Destination-SPACE/Weather-FeatherWing/README.md

# Weather FeatherWing
KiCad files for the Weather FeatherWing v1.4

## KiCanvas
View schematic and PCB files with [KiCanvas](https://kicanvas.org/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)

## Directory
### [🧾 Bill of Materials](manufacturing/assembly/weather-featherwing_bom.csv)
### [📐 Gerbers](manufacturing/fabrication/gerbers)
### [📰 Schematics](manufacturing/assembly)

Licensed under [CERN-OHL-P](LICENSE)
