Destination-SPACE/Weather-FeatherWing/manufacturing/assembly/weather-featherwing.pdf

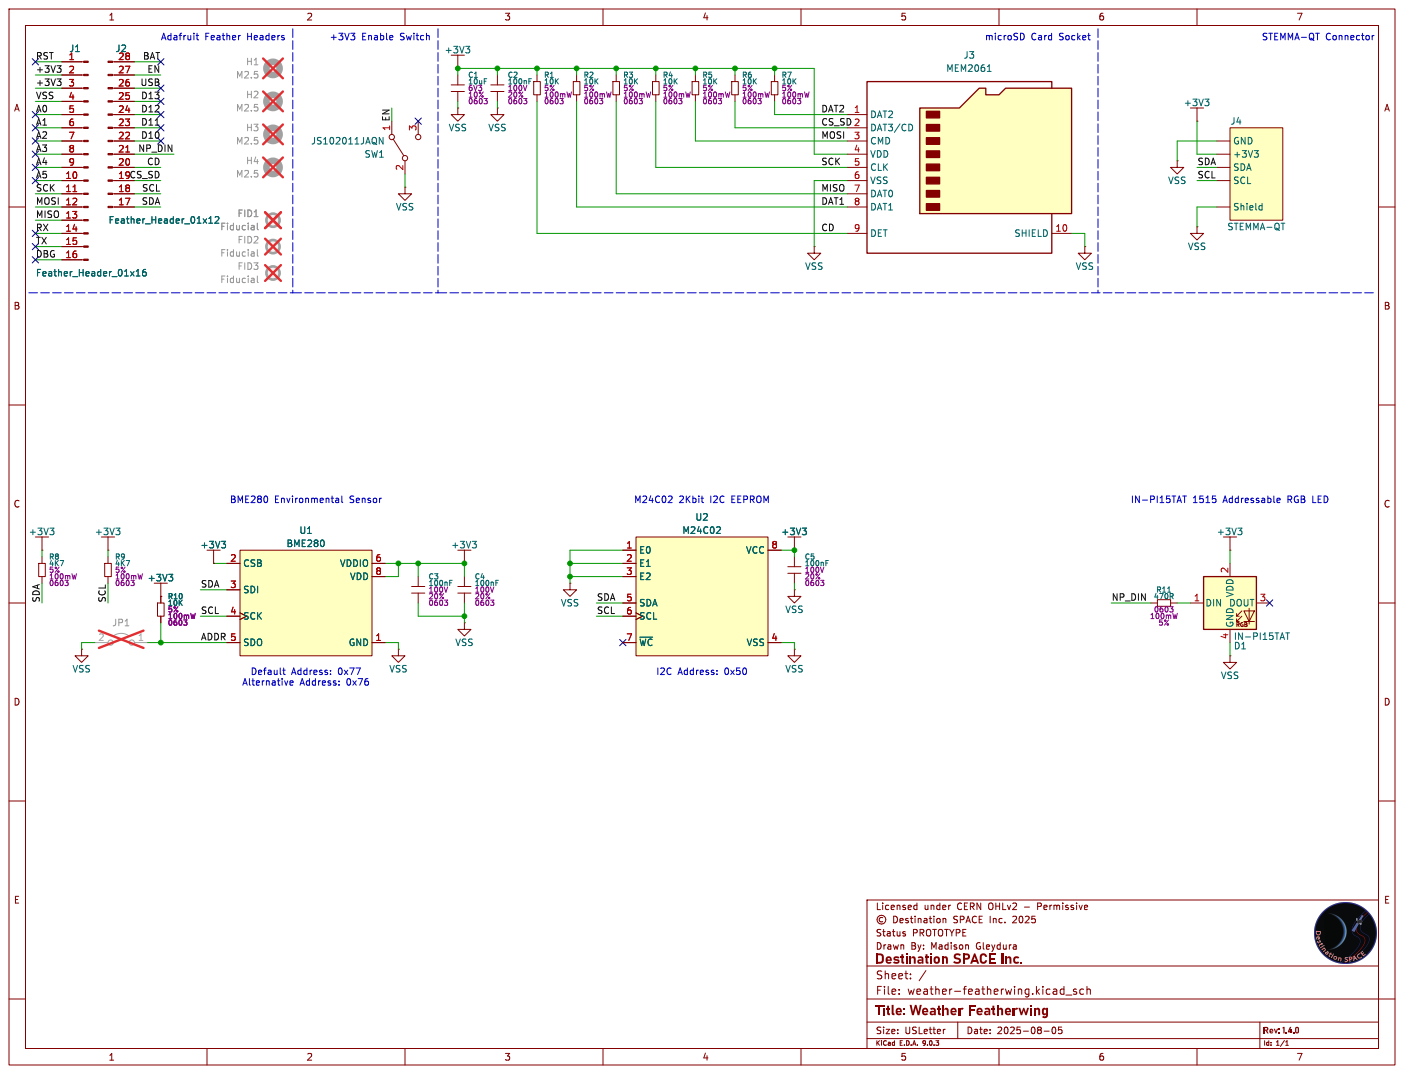
[picture p1: page 1]

Licensed under CERN OHLv2 - Permissive
DestinationSPACEInc. Drawn By: Madison Gleydura Status PROTOTYPE
