Destination-SPACE/Weather-FeatherWing/manufacturing/assembly/sch-v1_4_0.pdf

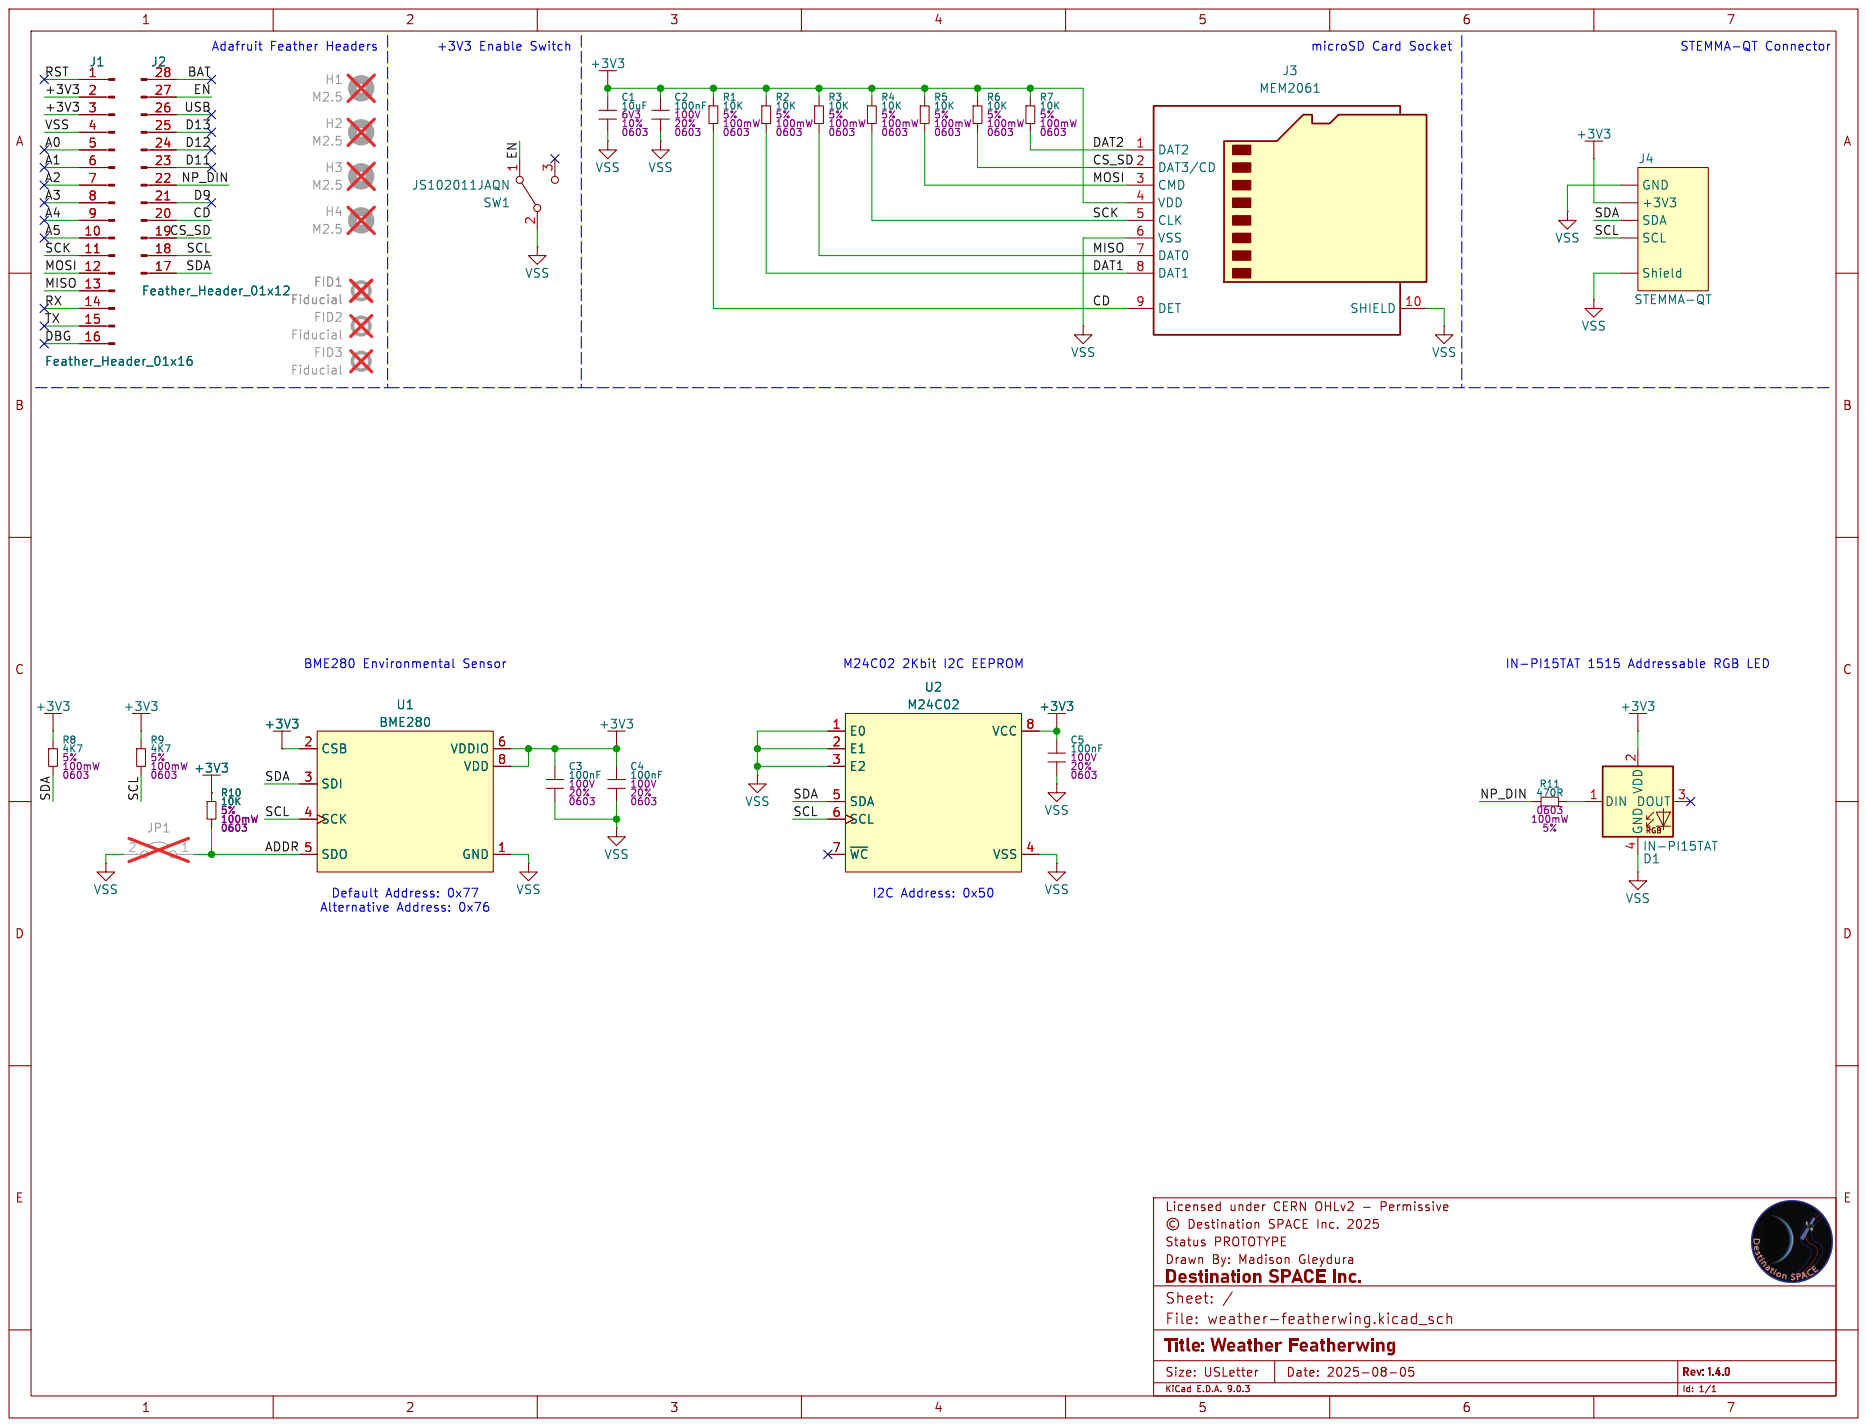
[picture p2: page 1]

DestinationSPACEInc. Drawn By: Madison Gleydura Status PROTOTYPE
