Destination-SPACE/Weather-FeatherWing/manufacturing/assembly/sch-v1_3_0.pdf

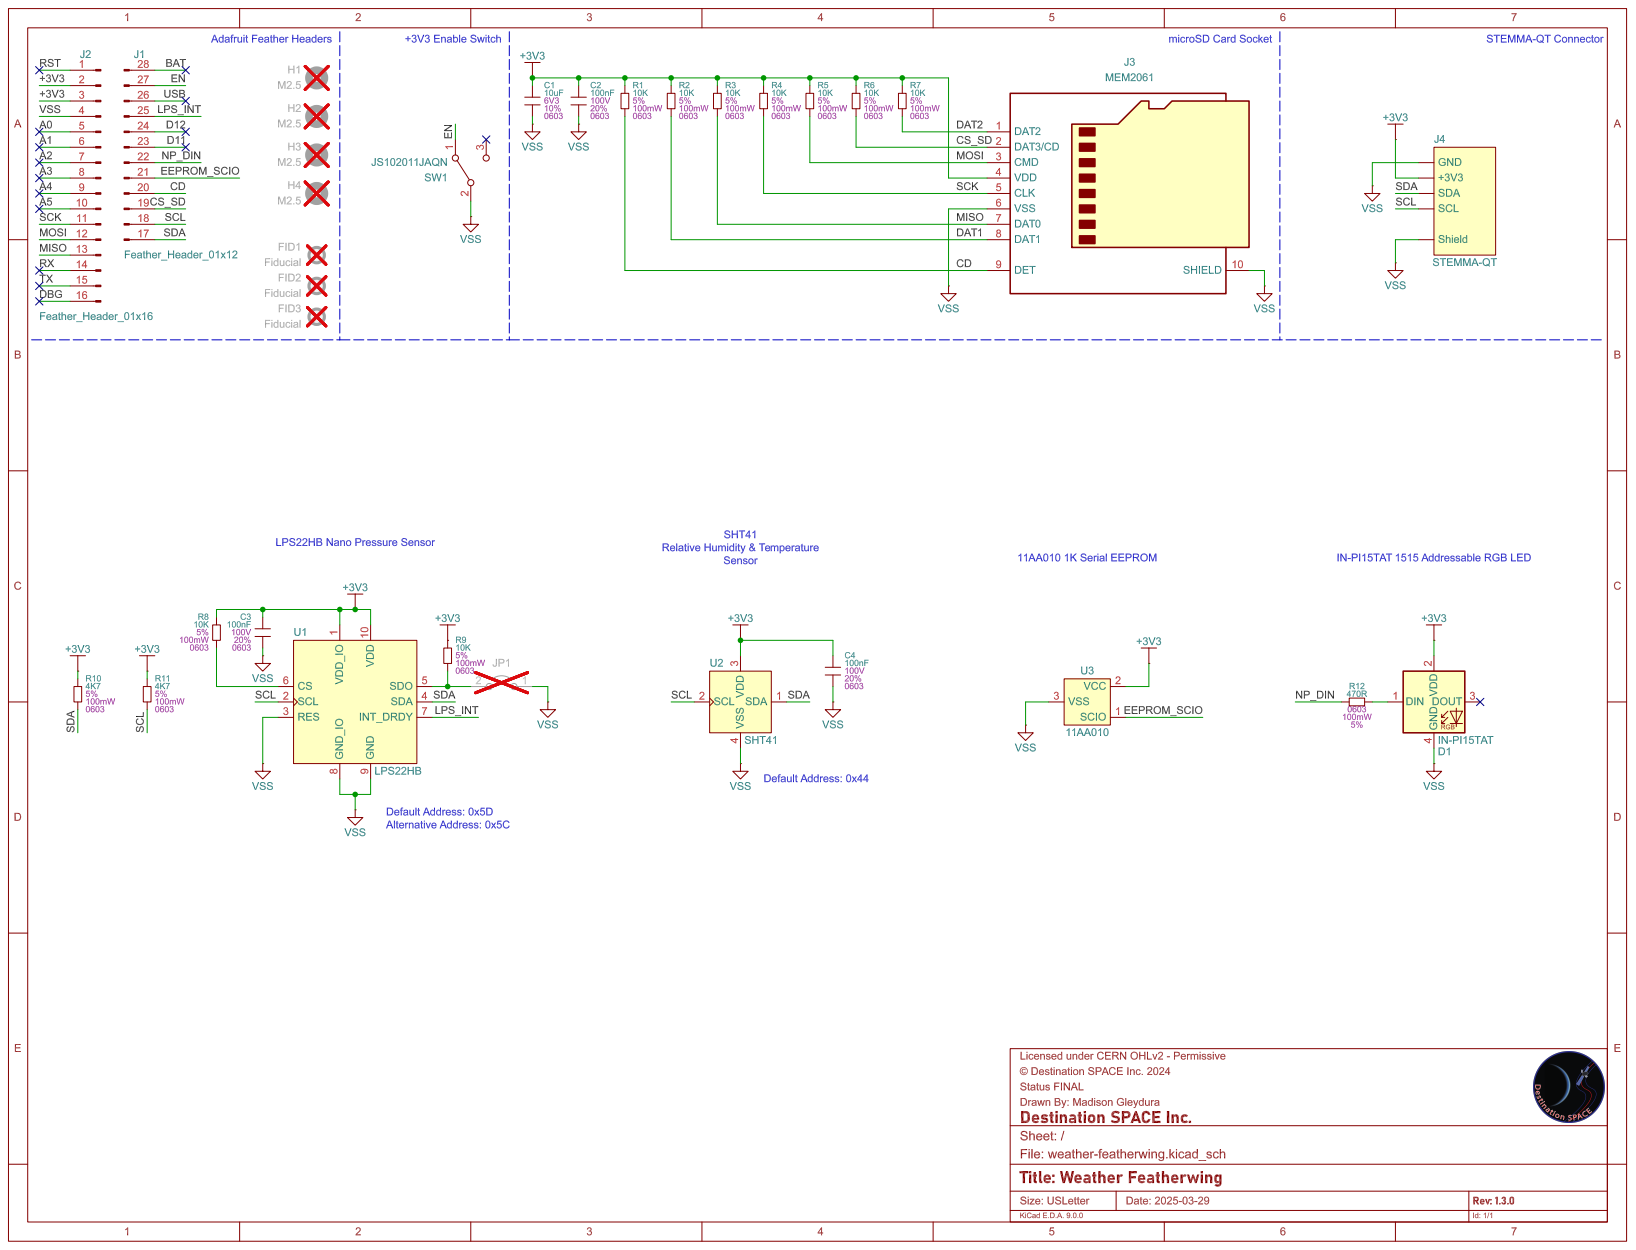
[picture p3: page 1]
