Destination-SPACE/Weather-FeatherWing/(commit log)

2025-03-29 broke out from DS-Weather-Station-V5 repository
    [weather-featherwing-B_Cu.gbr, weather-featherwing-B_Mask.gbr, weather-featherwing-B_Silkscreen.gbr, weather-featherwing-Edge_Cuts.gbr, weather-featherwing-F_Cu.gbr, weather-featherwing-F_Fab.gbr, weather-featherwing-F_Mask.gbr, weather-featherwing-F_Paste.gbr]
2025-04-01 updated year
    [weather-featherwing.kicad_sch]
2025-04-30 updated BOM
    [weather-featherwing_bom.csv]
2025-04-30 increased width of temp sensor slot from 0.6mm to 0.7mm
    [weather-featherwing.kicad_pcb]
2025-04-30 fixed part numbers
    [weather-featherwing.kicad_sch]
2025-04-30 clearance and bom settings
2025-08-05 replaced sensors with BME280
    [weather-featherwing-B_Cu.gbr, weather-featherwing-B_Mask.gbr, weather-featherwing-B_Silkscreen.gbr, weather-featherwing-Edge_Cuts.gbr, weather-featherwing-F_Cu.gbr, weather-featherwing-F_Fab.gbr, weather-featherwing-F_Mask.gbr, weather-featherwing-F_Paste.gbr]
2025-08-05 moved NeoPixel pin. fixed outputs
    [weather-featherwing-B_Cu.gbr, weather-featherwing-B_Mask.gbr, weather-featherwing-B_Silkscreen.gbr, weather-featherwing-Edge_Cuts.gbr, weather-featherwing-F_Cu.gbr, weather-featherwing-F_Fab.gbr, weather-featherwing-F_Mask.gbr, weather-featherwing-F_Paste.gbr]
2025-08-05 fixed 3v3 trace for eeprom
    [weather-featherwing-B_Cu.gbr, weather-featherwing-B_Mask.gbr, weather-featherwing-B_Silkscreen.gbr, weather-featherwing-Edge_Cuts.gbr, weather-featherwing-F_Cu.gbr, weather-featherwing-F_Fab.gbr, weather-featherwing-F_Mask.gbr, weather-featherwing-F_Paste.gbr]
2025-08-05 exported BOM
    [weather-featherwing_bom.csv]
2025-08-05 added temp BOM link
